jerry-weng/Lierda_tracker/ReadMe.txt

1.Telus  定位器 项目型号 LSD4BT0044-17D0 资料已归档-具体可问胡燕青查看
2.国内版 定位器 项目型号 LSD4BT0044-22D0 基于国内版，针对不同地区的情况，接入了不同的oc, 定制了不同功能

3.使用时请确认NB模组的固件版本是否为最新！
4.若程序无法打开 请复制到无中文路径文件夹中。
