jerry-weng/Lierda_tracker/产测源码与固件/ReadMe.txt

产测方案为杨彬与陈剑飞共同讨论设计
本源码为产测代码。
长按开机后由测试上位机自动完成测试流程
