jerry-weng/Lierda_tracker/服务器、oc与后台/ReadMe.txt

1.若要添加新设备，需首先在对应的服务器上导入相应设备
之后才能正常使用。
2.若要查询设备是否到达oc，可访问对应oc地址查看数据
（如果是国外oc可能需要翻墙）
