jerry-weng/Lierda_tracker/其他平台对应源码与固件/profile与编解码插件/ReadMe.txt

需在oc平台上上传的编解码插件与profile。 目前各个oc上面都已上传，由李磊磊负责
