jerry-weng/Lierda_tracker/其他平台对应源码与固件/台湾/ReadMe.txt

基于AIS_OC正式版 
分别寄送了
2个120的模组产品
2个150的模组产品
给台湾客户，源码
对应为TW_120和TW_150
