jerry-weng/Lierda_tracker/其他平台对应源码与固件/泰国/ReadMe.txt

1. AIS_OC正式版
最新功能软件，对应硬件为LSD4SA-NBTK000001_V01
若要使用新的硬件注意修改，参考文档 路径： 其他平台对应源码与固件/ReadMe.txt

2.AIS_OC定制版
基于1的软件，修改增加 上电自动开机、1分钟上报间隔等功能
若要使用新的硬件注意修改

3.True_OC
基于1的软件，修改南向IP地址
若要使用新的硬件注意修改

4.泰国_OC
实验室环境，产品测试认证用
