jerry-weng/Lierda_tracker/其他平台对应源码与固件/香港/ReadMe.txt

香港版为UDP版本，以一分钟的上报间隔，定时向测试的IP地址发送数据 --对应销售为 lierda赵夏
