jerry-weng/Lierda_tracker/固件下载工具/NB模组固件与下载软件/ReadMe.txt

1.若要更新NB模组程序 请使用UEUpdater 通过串口更新程序
2.不同的模块版本请对应，模组丝印上的型号即固件型号
比如 LSD4NBN-LB08000002_V02.03.fwpkg 即是Band8 的固件
