jerry-weng/Lierda_tracker/国内版本源码与固件/Doc/基站定位/ReadMe.txt

如果需要基站定位功能，需要联系中国电信开通对应SIM卡权限
MCU会通过NB模组读取SIM卡NCCID, 可通过NCCID（去掉最后一位校验位）对应的sim卡号调用电信所提供的接口获取基站信息（注：设备必须是在线或idle状态）

也可通过访问网站输入sim卡号信息来查看位置
https://www.ct10649.com:4821/ecportal/#
账号：fyb18067988525
密码：116040142Ckl

目前导入贤芯数据库的设备数量为400，若要增加请把新的对应excel发给贤芯对应人员 -- 路传军
