jerry-weng/Lierda_tracker/国内版本源码与固件/Doc/软件流程/协议/ReadMe.txt

由于当时打算做一个手环的项目，高坚和世东定义了一份coap协议
为了将目前的tracker兼容，CoAP协议——V01.02 文件中的数据信息填充字段，即为 NB-TRACKER-COAP国内版协议V1.6
