jerry-weng/Lierda_tracker/服务器、oc与后台/各OC地址.pdf

# 各OC地址

### 深圳OC

PS：开发测试⽤预留

开发者portal：https://120.234.26.167:8093 SP portal：https://120.234.26.167:8843账户/密码：lierda001/Lierda@001 南向设备对接地址：120.234.26.167
北向应⽤对接地址：120.234.26.167

### 泰国OC

PS：测试认证和泰国终端测试都⾛这个环境

开发者portal：https://203.172.115.67:8093
SP portal：https://203.172.115.67:8843账户/密码：Lierda001/Lierda.001 南向设备对接地址：10.10.45.196(内⽹) / 203.172.115.67(公⽹） 北向应⽤对接地址：10.10.46.196(私⽹) / 203.172.115.67(公⽹) 泰国应⽤服务器地址：10.10.36.88(私⽹，与oc对接使⽤) 泰国应⽤服务器域名：https://trackerars.lierda.com:50443

### AIS OC

SP portal：https://110.49.206.61:8843账户/密码：Lierda_APP/Lierda@2018 南向设备对接地址：10.143.132.1
北向应⽤对接地址：110.49.206.61

### 电信OC

PS：国内版使⽤

SP portal：https://180.101.146.80:8843账户/密码：lierdawulian/lierda_2017@NB 南向设备对接地址：117.60.157.137:5683 北向应⽤对接地址：https://device.api.ct10649.com:8743电信应⽤服务器域名：https://tracker.lierda-tracker.com

### 奥地利OC

SP portal：https://160.44.200.197/#/login账户/密码：HuaweiBonn_Lierda/Lierda_001 南向设备对接地址：160.44.206.237:5683 北向应⽤对接地址：160.44.201.125:8743

TRUE OC
ID：KCWZLMKtcDze6jlxV_280P7jfBoa 密码：ca7wzeK6TFTo1VroGet zoUwCnU0a 南向设备对接地址：180.214.223.116:5683 服务器平台订阅接⼝IP：180.214.223.118 8743/HTTPS https://180.214.223.118:8843/index.html ⽤户名Lierdaiot 密码Huawei@1234

1 https://10.10.46.196:8743 泰国OC 2 https://110.49.206.61:8743 AIS OC 3 https://120.234.26.167:8743 深圳OC 4.奥地利OC
5.trueOC
注：导⼊后台时注意OC 的序号
注2：在批量导⼊设备⾄泰国和AIS OC时，注意excel表格中，将设备名称这⼀栏填写为IMEI
