jerry-weng/Lierda_tracker/国内版本源码与固件/Doc/软件流程/数据上报与模式配置流程.pdf

硬件 | OC平台 （插件）

## 服务器

## 数据上报帧

上报

## 平台回复帧

(8字节，例：FAFA5B21C3DA0000
由插件决定)

## 服务器回复帧

## 休眠---等待 下个周期唤 醒上报

## 跳过前37字节 根据协议解析后续

数据

## 指令下发

## 有缓存指令

## 当前状态帧 更新当前状态

## 平台回复帧

(8字节，例：FAFA5B21C3DA0000
由插件决定)
