jerry-weng/Lierda_tracker/国内版本源码与固件/Doc/基站定位/NCCID.png

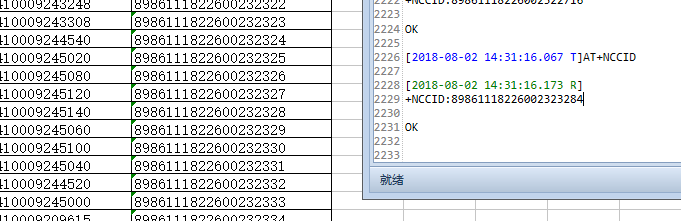
国内版本源码与固件/Doc/基站定位/NCCID.png
