jerry-weng/Lierda_tracker/服务器、oc与后台/app下载地址/coap版本.png

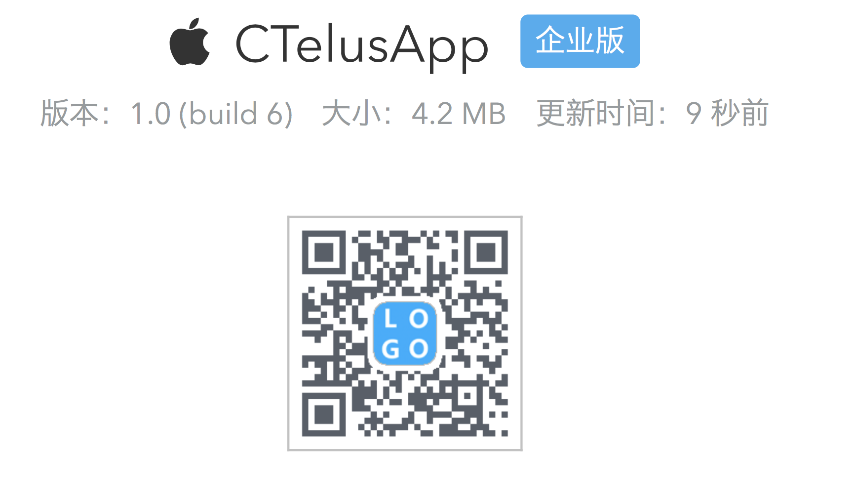
服务器、oc与后台/app下载地址/coap版本.png
