jerry-weng/Lierda_tracker/DeviceRegFileTemplate_2018-10-16 13_51_25.xls

Sheet: Sheet1
verifyCode | nodeId | psk | endUserId | timeout | name | mute | manufacturerId | manufacturerName | deviceType | model | region | location | protocolType | tags | timezone | latitude | longitude | address | groupId | customField | imsi | isSecure
865352030667058 | 865352030667058 | 12345678 |  | 0 |  | FALSE | LierdaWSN | LierdaWSN | NB05 | Band |  |  | Coap
865352030644444 | 865352030644444 | 12345678 |  | 0 |  | FALSE | LierdaWSN | LierdaWSN | NB05 | Band |  |  | Coap

Sheet: 参数说明
参数名称 | 字段说明
verifyCode | 验证码。用于设备注册和激活。 必选。 取值范围：长度不超过256的字符串。
nodeId | 设备唯一物理标识。需要和“verifyCode”值保持一致。 必选。 取值范围：长度不超过256的字符串。
psk | 随机psk参数。（psk：pre-shared key，预共享密钥。） 注册安全设备必选，非安全设备可选。 取值范围：长度为8～32的字符串,必须是16进制的字符。
endUserId | 终端用户ID。 可选。 取值范围：长度不超过256的字符串。
timeout | 超时时间。当调用北向接口对设备开户，在超时时间内可绑定设备，若超过timeout时间且未绑定设备，则会删除超时的开户信息。 可选。 取值范围：0～2147483647。若填写为“0”，则表示设备验证码不会失效（建议填写为“0”）。 默认值：180(默认值可配置，具体配置值请咨询物联网平台运维人员。) 单位：秒。
name | 设备名称。 可选。 取值范围：长度不超过256的字符串。 不能包含特殊符+/?%#|;&=
mute | 资产是否冻结。 可选。 取值范围： •“TRUE”：冻结资产，不可上报数据。 •“FALSE”：不冻结资产，可以上报数据。 • 建议填写为“FALSE“
manufacturerId | 厂商ID。 可选（建议填写）。 取值范围：长度不超过256的字符串。 | 为了避免接入的设备不可用。manufacturerId,manufacturerName,deviceType,model,protocolType字段需要与设备profile的字段值保持一致。
manufacturerName | 厂商名称。 可选（建议填写）。 取值范围：长度不超过256的字符串。
deviceType | 设备类型。 可选（建议填写）。 取值范围：长度不超过256的字符串。
model | 设备型号。 可选（建议填写）。 取值范围：长度不超过256的字符串。
region | 设备区域。 可选。 取值范围：长度不超过256的字符串。 不能包含特殊符+/?%#|;&=
location | 设备位置。 可选。 取值范围：长度不超过1024的字符串。 不能包含特殊符+/?%#|;&=
protocolType | 设备协议类型。 可选（建议填写）。 取值范围：长度不超过256的字符串。
tags | 标签。给设备打标签可以统一管理一类设备。 可选。 取值范围：长度不超过100个标签。
timeZone | 时区。设备所在区域的时区。 可选。 取值范围：长度不超过256的字符串。例如Asia/Shanghai、Asia/Tokyo、Europe/London
latitude | 纬度。设备所在的纬度。 可选。 取值范围：-90～90。
longitude | 纬度。设备所在的经度。 可选。 取值范围：-180～180。
address | 地址。设备地址。 可选。 取值范围：长度不超过256的字符串。
groupId | 组Id。设备所属群组的Id 可选。 取值范围：长度不超过256的字符串。
customField | 自定义字段。设备的自定义字段。 可选。 取值范围：长度不超过256个自定义字段。 示例：[{"fieldName":"owner","fieldValue":"SuperAdmin","fieldType":"String"}]
imsi | NB终端imsi，用于消息计费。 可选。 取值范围：长度不超过256的字符串。
isSecure | 设备安全模式。 可选。 取值范围：true 或者 false（当non-DTLS开关关闭时，默认true，设置无效。）

Sheet: Parameter Description
Parameter Name | Parameter Description
verifyCode | This parameter specifies a verification code, which is used to register and activate a device. This parameter is mandatory. Value: a string of a maximum of 256 characters
nodeId | This parameter uniquely identifies a device. This parameter is mandatory and must be consistent with verifyCode. Value: a string of a maximum of 256 characters
psk | This parameter specifies a pre-shared key. This parameter is mandatory for registered security devices and optional for registering non-secure devices. Value: a hexadecimal string of 8 to 32 characters
endUserId | This parameter identifies an end user. This parameter is optional. Value: a string of a maximum of 256 characters
timeout | This parameter specifies the timeout period for binding a device. When the northbound interface is called to register a device, the device can be bound within the timeout period. If the device is not bound within the timeout period, timeout registration information will be deleted.(recommended value: 0) This parameter is optional. Value range: 0-2147483647 (If this parameter is set to 0, the verification code will always be valid.) Default value: 180(The default value can be configured. For details on the specific value, contact IoT platform O&M personnel.) Unit: seconds
name | This parameter specifies the name of a device. This parameter is optional. Value: a string of a maximum of 256 characters, which cannot contain special characters +/?%#|;&=
mute | This parameter specifies whether an asset is frozen. This parameter is optional. Value: a string of a maximum of 256 characters Recommended value: FALSE
manufacturerId | This parameter specifies the ID of a manufacturer. This parameter is optional(You are advised to enter a value). Value: a string of a maximum of 256 characters | To ensure that the connected device can be used, set manufacturerId, manufacturerName, deviceType, model, and protocolType to the same as those in the device profile.
manufacturerName | This parameter specifies the name of a manufacturer. This parameter is optional(You are advised to enter a value). Value: a string of a maximum of 256 characters
deviceType | This parameter specifies the type of a device. This parameter is optional(You are advised to enter a value). Value: a string of a maximum of 256 characters
model | This parameter specifies the model of a device. This parameter is optional(You are advised to enter a value). Value: a string of a maximum of 256 characters
region | This parameter specifies the region of a device. This parameter is optional. Value: a string of a maximum of 256 characters, which cannot contain special characters +/?%#|;&=
location | This parameter specifies the location of a device. This parameter is optional. Value: a string of a maximum of 1024 characters, which cannot contain special characters +/?%#|;&=
protocolType | This parameter specifies the protocol used by a device. This parameter is optional(You are advised to enter a value). Value: a string of a maximum of 256 characters
tags | This parameter specifies device label can manage the type of device centrally. This parameter is optional. Value: length does not exceed 100 label
timeZone | This parameter specifies the time zone of the area where the device is located. This parameter is optional. Value: a string of a maximum of 256 characters", e.g.,Asia/Shanghai, Asia/Tokyo, Europe/London
latitude | This parameter specifies the latitude where the device is located. This parameter is optional. Value range: -90 to 90
longitude | This parameter specifies the longitude where the device is located. This parameter is optional. Value range: -180 to 180
address | This parameter specifies the device address. This parameter is optional. Value: a string of a maximum of 256 characters
groupId | This parameter identifies the group to which the device belongs. This parameter is optional. Value: a string of a maximum of 256 characters
customField | This parameter specifies the field customized for the device. It is available for the batch device registration function on the NAE portal, not the SP portal. This parameter is optional. Value: a string of a maximum of 256 characters Example: [{"fieldName":"owner","fieldValue":"SuperAdmin","fieldType":"String"}]
imsi | This parameter specifies the IMSI of an NB-IoT device. It is used for message charging. This parameter is optional. Value: a string of a maximum of 64 characters
isSecure | This parameter specifies the security mode of a device. This parameter is optional. Value: TRUE or FALSE (If the non-DTLS switch is disabled, this parameter is set to TRUE by default, indicating that the security mode setting is invalid.)
