jerry-weng/Lierda_tracker/硬件相关/位号图/LSD4BT0044-17D0_位号图(BOT)_Rev05.pdf

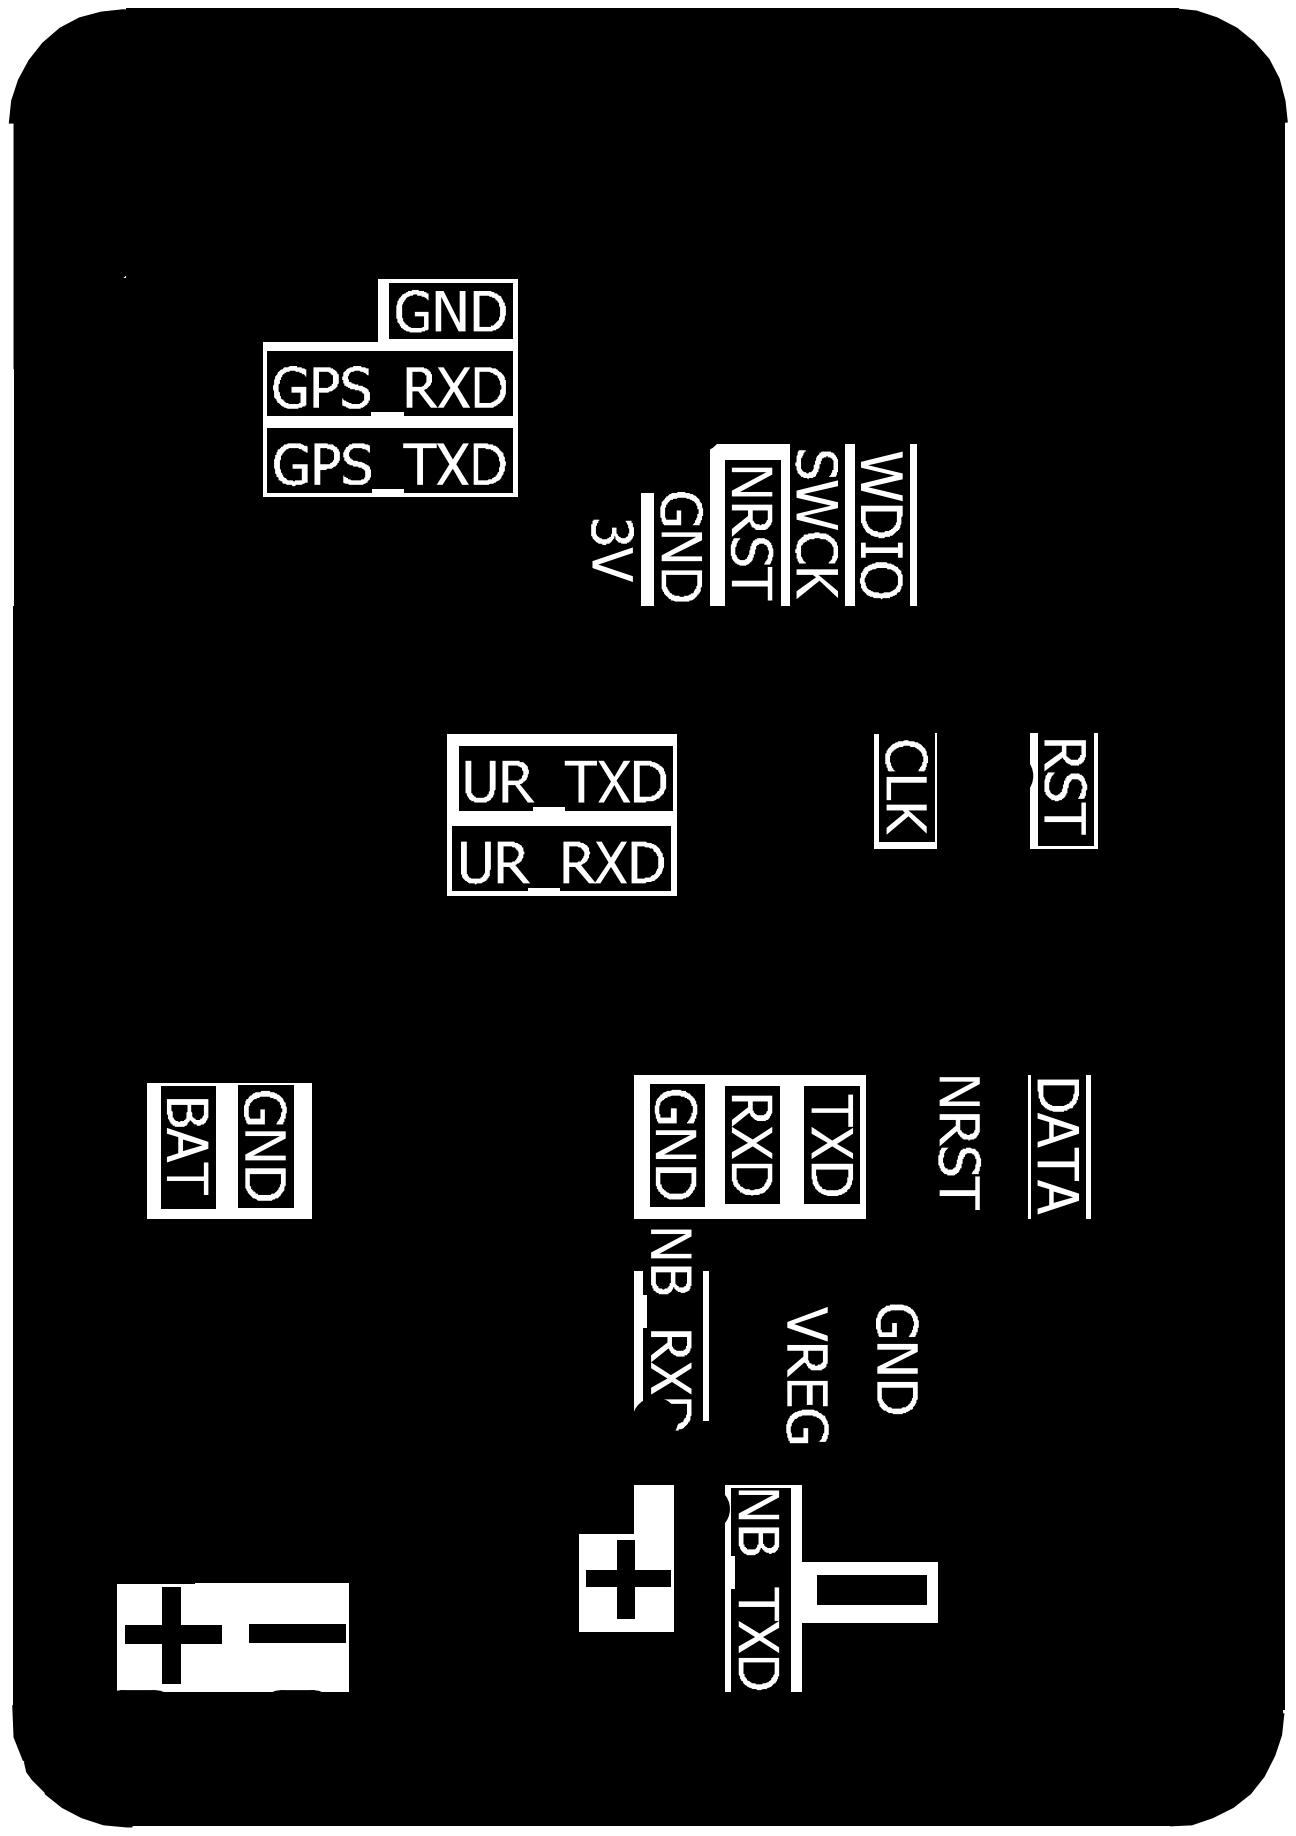
[picture p7: page 1]
