jerry-weng/Lierda_tracker/硬件相关/位号图/LSD4BT0044-17D0_位号图(TOP)_Rev05.pdf

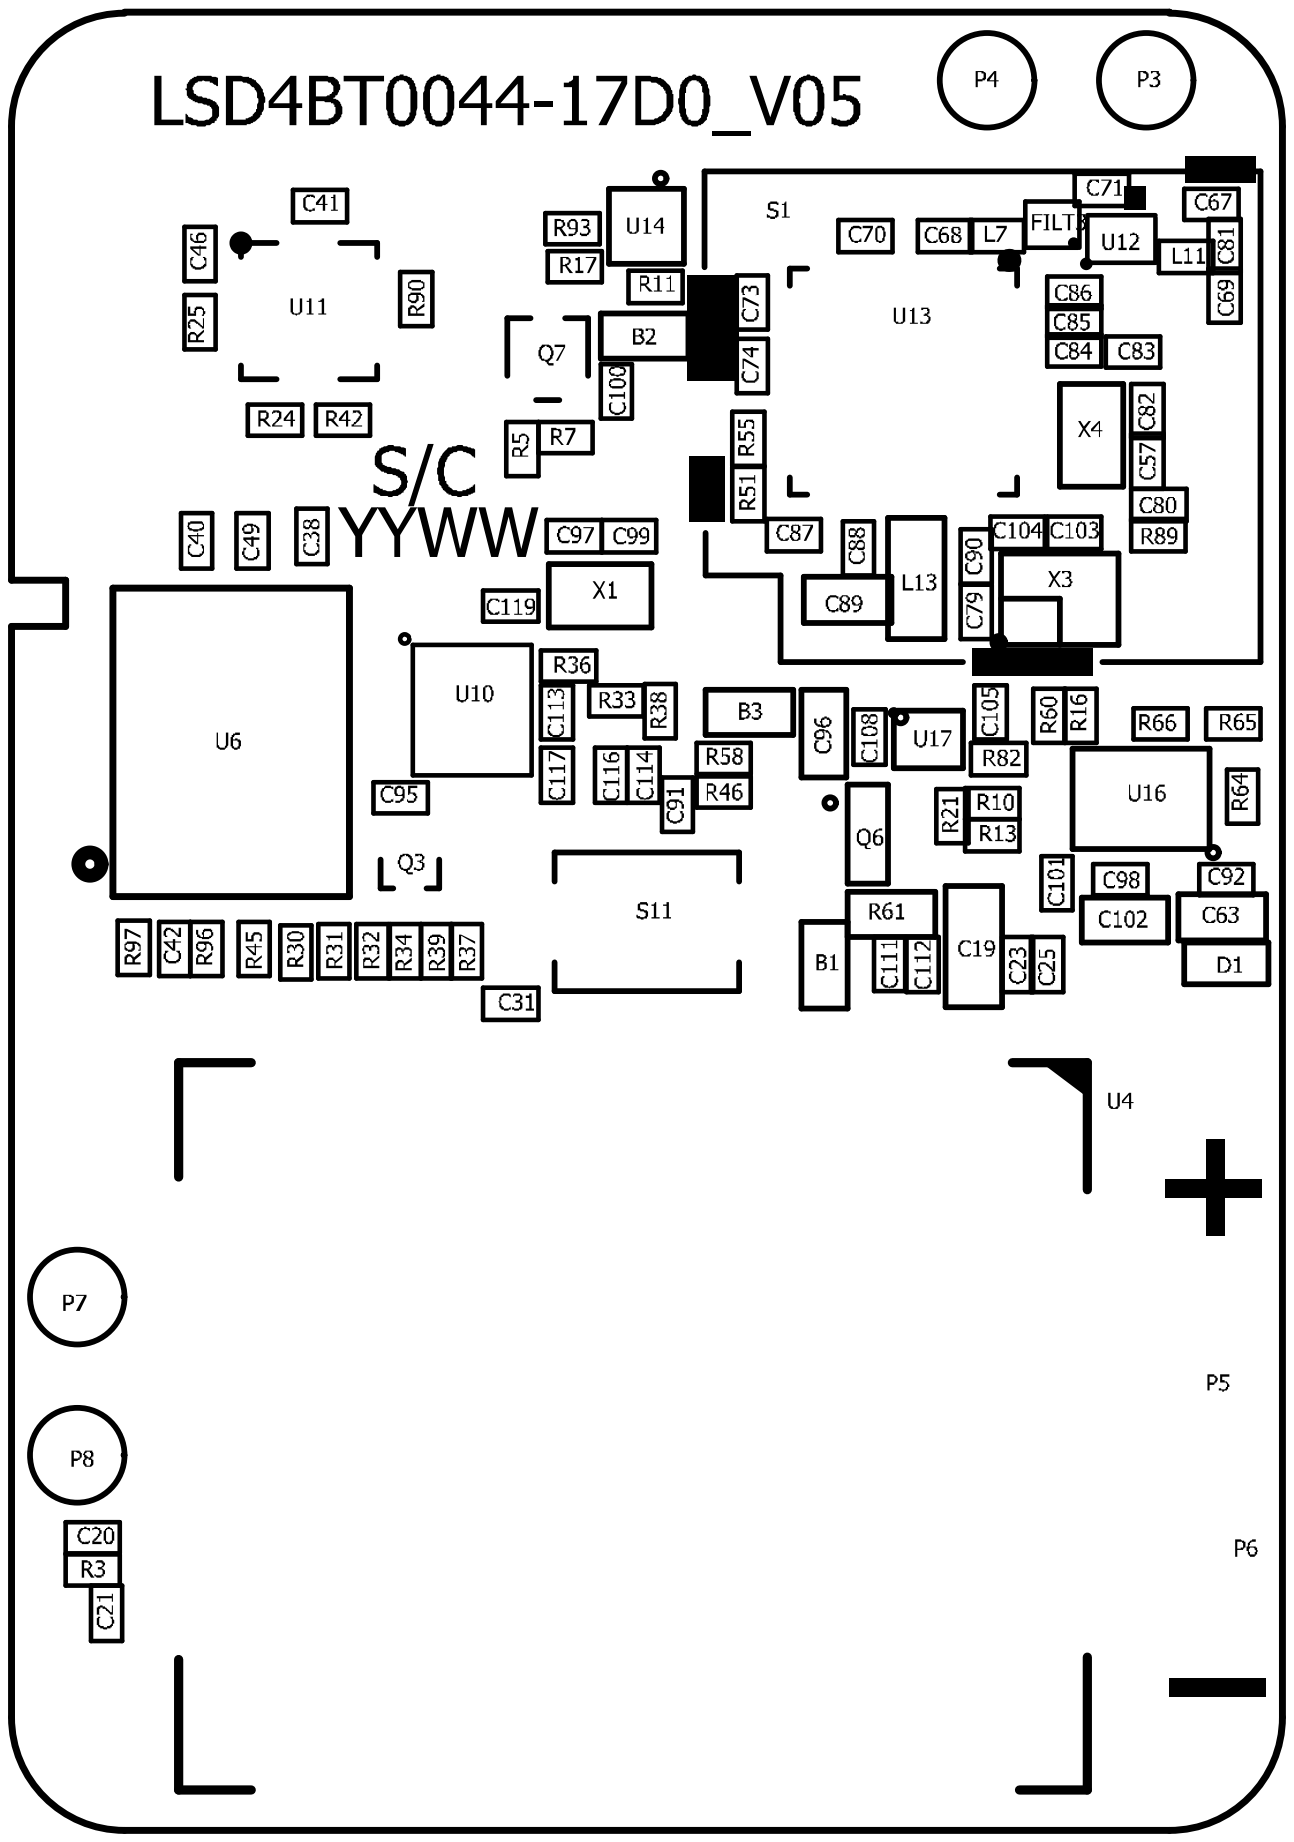
[picture p8: page 1]
