jerry-weng/Lierda_tracker/国内版本源码与固件/Doc/软件流程/硬件开机注册流程.pdf

硬件 | OC平台 （插件）

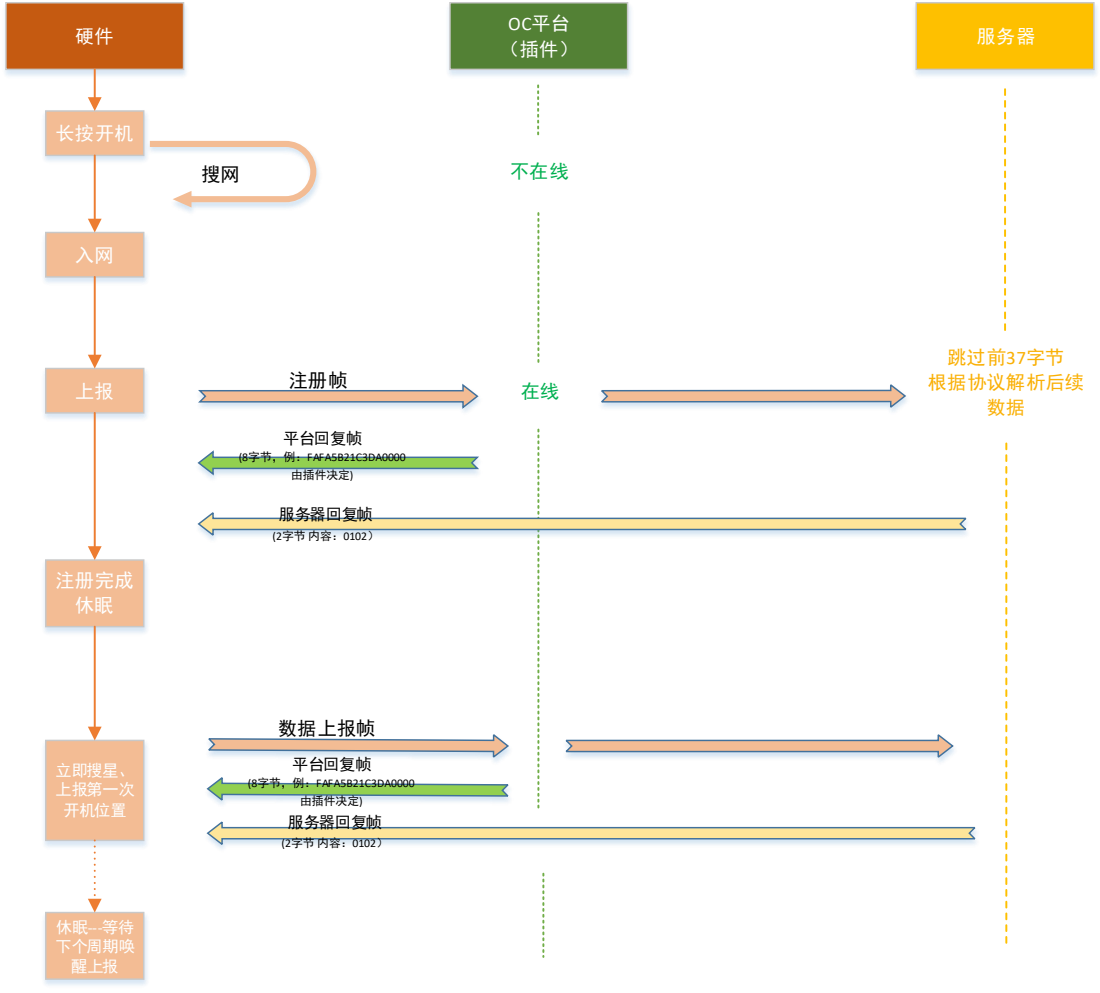
[picture p9: page 1]
服务器; 注册帧; 长按开机; 注册完成 休眠; 立即搜星、 上报第一次 开机位置; 不在线; 平台回复帧; (8字节，例：FAFA5B21C3DA0000; 由插件决定); 服务器回复帧; 数据上报帧; 由插件决定) 服务器回复帧; 休眠---等待 下个周期唤 醒上报; 跳过前37字节 根据协议解析后续 数据
