jerry-weng/Lierda_tracker/Telus版本源码与固件/Locator_L051T8_Schedule0719_150/Locator_L051T8.ioc

Mcu.UserName=STM32L051T8Yx
PA0.GPIO_Label=KEY
PA0.Signal=GPXTI0
PA10.Signal=USART1_RX
PA11.GPIO_Label=GPS_SW
PA11.Signal=GPIO_Output
PA12.GPIO_Label=GPS_INT
PA12.Signal=GPIO_Input
PA13.Signal=SYS_SWDIO
PA14.Signal=SYS_SWCLK
PA15.GPIO_Label=LED3_G
PA15.Signal=GPIO_Output
PA2.Signal=USART2_TX
PA3.Signal=USART2_RX
PA4.GPIO_Label=BAT_V_DET
PA4.Signal=ADC_IN4
PA5.GPIO_Label=NPPR
PA5.Signal=GPXTI5
PA6.GPIO_Label=NCHG
PA6.Signal=GPXTI6
PA8.GPIO_Label=GPS_RST
PA8.Signal=GPIO_Output
PA9.Signal=USART1_TX
PB0.GPIO_Label=NB_SW
PB0.Signal=GPIO_Output
PB1.GPIO_Label=NB_RI
PB1.Signal=GPIO_Input
PB10.Signal=LPUART1_TX
PB11.Signal=LPUART1_RX
PB2.GPIO_Label=NB_RESET
PB2.Signal=GPIO_Output
PB3.GPIO_Label=LED2_B
PB3.Signal=GPIO_Output
PB4.GPIO_Label=LED1_R
PB4.Signal=GPIO_Output
PB5.GPIO_Label=PS_INT
PB5.Signal=GPIO_Input
PC14-OSC32_IN.Signal=RCC_OSC32_IN
PC15-OSC32_OUT.Signal=RCC_OSC32_OUT
