jerry-weng/Lierda_tracker/其他平台对应源码与固件/台湾/Locator_L051T8_AIS_alarm_AIS_NW_OTA2_SENSOR_TW120/Src/usart.c

/**
  ******************************************************************************
  * File Name          : USART.c
  * Description        : This file provides code for the configuration
  *                      of the USART instances.
  ******************************************************************************
  ** This notice applies to any and all portions of this file
  * that are not between comment pairs USER CODE BEGIN and
  * USER CODE END. Other portions of this file, whether 
  * inserted by the user or by software development tools
  * are owned by their respective copyright owners.
  *
  * COPYRIGHT(c) 2017 STMicroelectronics
  *
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
  ******************************************************************************
  */

/* Includes ------------------------------------------------------------------*/
#include "usart.h"

#include "gpio.h"
#include "dma.h"

/* USER CODE BEGIN 0 */
USART_RECEIVETYPE UsartType;
USART_RECEIVETYPE2 UsartType2;
/* USER CODE END 0 */

UART_HandleTypeDef hlpuart1;
UART_HandleTypeDef huart1;
UART_HandleTypeDef huart2;
DMA_HandleTypeDef hdma_lpuart1_rx;
DMA_HandleTypeDef hdma_lpuart1_tx;
DMA_HandleTypeDef hdma_usart1_rx;
DMA_HandleTypeDef hdma_usart1_tx;
DMA_HandleTypeDef hdma_usart2_rx;
DMA_HandleTypeDef hdma_usart2_tx;

/* LPUART1 init function */

void MX_LPUART1_UART_Init(void)
{

  hlpuart1.Instance = LPUART1;
  hlpuart1.Init.BaudRate = 9600;
  hlpuart1.Init.WordLength = UART_WORDLENGTH_8B;
  hlpuart1.Init.StopBits = UART_STOPBITS_1;
  hlpuart1.Init.Parity = UART_PARITY_NONE;
  hlpuart1.Init.Mode = UART_MODE_TX_RX;
  hlpuart1.Init.HwFlowCtl = UART_HWCONTROL_NONE;
  hlpuart1.Init.OneBitSampling = UART_ONE_BIT_SAMPLE_DISABLE;
  hlpuart1.AdvancedInit.AdvFeatureInit = UART_ADVFEATURE_NO_INIT;
  if (HAL_UART_Init(&hlpuart1) != HAL_OK)
  {
    _Error_Handler(__FILE__, __LINE__);
  }

}
/* USART1 init function */

void MX_USART1_UART_Init(void)
{

  huart1.Instance = USART1;
  huart1.Init.BaudRate = 9600;
  huart1.Init.WordLength = UART_WORDLENGTH_8B;
  huart1.Init.StopBits = UART_STOPBITS_1;
  huart1.Init.Parity = UART_PARITY_NONE;
  huart1.Init.Mode = UART_MODE_TX_RX;
  huart1.Init.HwFlowCtl = UART_HWCONTROL_NONE;
  huart1.Init.OverSampling = UART_OVERSAMPLING_16;
  huart1.Init.OneBitSampling = UART_ONE_BIT_SAMPLE_DISABLE;
  huart1.AdvancedInit.AdvFeatureInit = UART_ADVFEATURE_NO_INIT;
  if (HAL_UART_Init(&huart1) != HAL_OK)
  {
    _Error_Handler(__FILE__, __LINE__);
  }

}
/* USART2 init function */

void MX_USART2_UART_Init(void)
{

  huart2.Instance = USART2;
  huart2.Init.BaudRate = 9600;
  huart2.Init.WordLength = UART_WORDLENGTH_8B;
  huart2.Init.StopBits = UART_STOPBITS_1;
  huart2.Init.Parity = UART_PARITY_NONE;
  huart2.Init.Mode = UART_MODE_TX_RX;
  huart2.Init.HwFlowCtl = UART_HWCONTROL_NONE;
  huart2.Init.OverSampling = UART_OVERSAMPLING_16;
  huart2.Init.OneBitSampling = UART_ONE_BIT_SAMPLE_DISABLE;
  huart2.AdvancedInit.AdvFeatureInit = UART_ADVFEATURE_NO_INIT;
  if (HAL_UART_Init(&huart2) != HAL_OK)
  {
    _Error_Handler(__FILE__, __LINE__);
  }

}

void HAL_UART_MspInit(UART_HandleTypeDef* uartHandle)
{

  GPIO_InitTypeDef GPIO_InitStruct;
  if(uartHandle->Instance==LPUART1)
  {
    /* LPUART1 clock enable */
    __HAL_RCC_LPUART1_CLK_ENABLE();
  
    /**LPUART1 GPIO Configuration    
    PB11     ------> LPUART1_RX
    PB10     ------> LPUART1_TX 
    */
    GPIO_InitStruct.Pin = GPIO_PIN_11|GPIO_PIN_10;
    GPIO_InitStruct.Mode = GPIO_MODE_AF_PP;
    GPIO_InitStruct.Pull = GPIO_PULLUP;
    GPIO_InitStruct.Speed = GPIO_SPEED_FREQ_VERY_HIGH;
    GPIO_InitStruct.Alternate = GPIO_AF4_LPUART1;
    HAL_GPIO_Init(GPIOB, &GPIO_InitStruct);

    /* LPUART1 DMA Init */
    /* LPUART1_RX Init */
    hdma_lpuart1_rx.Instance = DMA1_Channel3;
    hdma_lpuart1_rx.Init.Request = DMA_REQUEST_5;
    hdma_lpuart1_rx.Init.Direction = DMA_PERIPH_TO_MEMORY;
    hdma_lpuart1_rx.Init.PeriphInc = DMA_PINC_DISABLE;
    hdma_lpuart1_rx.Init.MemInc = DMA_MINC_ENABLE;
    hdma_lpuart1_rx.Init.PeriphDataAlignment = DMA_PDATAALIGN_BYTE;
    hdma_lpuart1_rx.Init.MemDataAlignment = DMA_MDATAALIGN_BYTE;
    hdma_lpuart1_rx.Init.Mode = DMA_NORMAL;
    hdma_lpuart1_rx.Init.Priority = DMA_PRIORITY_LOW;
    if (HAL_DMA_Init(&hdma_lpuart1_rx) != HAL_OK)
    {
      _Error_Handler(__FILE__, __LINE__);
    }

    __HAL_LINKDMA(uartHandle,hdmarx,hdma_lpuart1_rx);

    /* LPUART1_TX Init */
    hdma_lpuart1_tx.Instance = DMA1_Channel2;
    hdma_lpuart1_tx.Init.Request = DMA_REQUEST_5;
    hdma_lpuart1_tx.Init.Direction = DMA_MEMORY_TO_PERIPH;
    hdma_lpuart1_tx.Init.PeriphInc = DMA_PINC_DISABLE;
    hdma_lpuart1_tx.Init.MemInc = DMA_MINC_ENABLE;
    hdma_lpuart1_tx.Init.PeriphDataAlignment = DMA_PDATAALIGN_BYTE;
    hdma_lpuart1_tx.Init.MemDataAlignment = DMA_MDATAALIGN_BYTE;
    hdma_lpuart1_tx.Init.Mode = DMA_NORMAL;
    hdma_lpuart1_tx.Init.Priority = DMA_PRIORITY_LOW;
    if (HAL_DMA_Init(&hdma_lpuart1_tx) != HAL_OK)
    {
      _Error_Handler(__FILE__, __LINE__);
    }

    __HAL_LINKDMA(uartHandle,hdmatx,hdma_lpuart1_tx);

    /* LPUART1 interrupt Init */
    HAL_NVIC_SetPriority(AES_RNG_LPUART1_IRQn, 0, 0);
    HAL_NVIC_EnableIRQ(AES_RNG_LPUART1_IRQn);
  }
  else if(uartHandle->Instance==USART1)
  {
    /* USART1 clock enable */
    __HAL_RCC_USART1_CLK_ENABLE();
  
    /**USART1 GPIO Configuration    
    PA10     ------> USART1_RX
    PA9     ------> USART1_TX 
    */
    GPIO_InitStruct.Pin = GPIO_PIN_10|GPIO_PIN_9;
    GPIO_InitStruct.Mode = GPIO_MODE_AF_PP;
    GPIO_InitStruct.Pull = GPIO_PULLUP;
    GPIO_InitStruct.Speed = GPIO_SPEED_FREQ_VERY_HIGH;
    GPIO_InitStruct.Alternate = GPIO_AF4_USART1;
    HAL_GPIO_Init(GPIOA, &GPIO_InitStruct);

    /* USART1 DMA Init */
    /* USART1_RX Init */
    hdma_usart1_rx.Instance = DMA1_Channel5;
    hdma_usart1_rx.Init.Request = DMA_REQUEST_3;
    hdma_usart1_rx.Init.Direction = DMA_PERIPH_TO_MEMORY;
    hdma_usart1_rx.Init.PeriphInc = DMA_PINC_DISABLE;
    hdma_usart1_rx.Init.MemInc = DMA_MINC_ENABLE;
    hdma_usart1_rx.Init.PeriphDataAlignment = DMA_PDATAALIGN_BYTE;
    hdma_usart1_rx.Init.MemDataAlignment = DMA_MDATAALIGN_BYTE;
    hdma_usart1_rx.Init.Mode = DMA_NORMAL;
    hdma_usart1_rx.Init.Priority = DMA_PRIORITY_LOW;
    if (HAL_DMA_Init(&hdma_usart1_rx) != HAL_OK)
    {
      _Error_Handler(__FILE__, __LINE__);
    }

    __HAL_LINKDMA(uartHandle,hdmarx,hdma_usart1_rx);

    /* USART1_TX Init */
    hdma_usart1_tx.Instance = DMA1_Channel4;
    hdma_usart1_tx.Init.Request = DMA_REQUEST_3;
    hdma_usart1_tx.Init.Direction = DMA_MEMORY_TO_PERIPH;
    hdma_usart1_tx.Init.PeriphInc = DMA_PINC_DISABLE;
    hdma_usart1_tx.Init.MemInc = DMA_MINC_ENABLE;
    hdma_usart1_tx.Init.PeriphDataAlignment = DMA_PDATAALIGN_BYTE;
    hdma_usart1_tx.Init.MemDataAlignment = DMA_MDATAALIGN_BYTE;
    hdma_usart1_tx.Init.Mode = DMA_NORMAL;
    hdma_usart1_tx.Init.Priority = DMA_PRIORITY_LOW;
    if (HAL_DMA_Init(&hdma_usart1_tx) != HAL_OK)
    {
      _Error_Handler(__FILE__, __LINE__);
    }

    __HAL_LINKDMA(uartHandle,hdmatx,hdma_usart1_tx);

    /* USART1 interrupt Init */
    HAL_NVIC_SetPriority(USART1_IRQn, 0, 0);
    HAL_NVIC_EnableIRQ(USART1_IRQn);
  }
  else if(uartHandle->Instance==USART2)
  {
    /* USART2 clock enable */
    __HAL_RCC_USART2_CLK_ENABLE();
  
    /**USART2 GPIO Configuration    
    PA2     ------> USART2_TX
    PA3     ------> USART2_RX 
    */
    GPIO_InitStruct.Pin = GPIO_PIN_2|GPIO_PIN_3;
    GPIO_InitStruct.Mode = GPIO_MODE_AF_PP;
    GPIO_InitStruct.Pull = GPIO_PULLUP;
    GPIO_InitStruct.Speed = GPIO_SPEED_FREQ_VERY_HIGH;
    GPIO_InitStruct.Alternate = GPIO_AF4_USART2;
    HAL_GPIO_Init(GPIOA, &GPIO_InitStruct);

    /* USART2 DMA Init */
    /* USART2_RX Init */
    hdma_usart2_rx.Instance = DMA1_Channel6;
    hdma_usart2_rx.Init.Request = DMA_REQUEST_4;
    hdma_usart2_rx.Init.Direction = DMA_PERIPH_TO_MEMORY;
    hdma_usart2_rx.Init.PeriphInc = DMA_PINC_DISABLE;
    hdma_usart2_rx.Init.MemInc = DMA_MINC_ENABLE;
    hdma_usart2_rx.Init.PeriphDataAlignment = DMA_PDATAALIGN_BYTE;
    hdma_usart2_rx.Init.MemDataAlignment = DMA_MDATAALIGN_BYTE;
    hdma_usart2_rx.Init.Mode = DMA_NORMAL;
    hdma_usart2_rx.Init.Priority = DMA_PRIORITY_LOW;
    if (HAL_DMA_Init(&hdma_usart2_rx) != HAL_OK)
    {
      _Error_Handler(__FILE__, __LINE__);
    }

    __HAL_LINKDMA(uartHandle,hdmarx,hdma_usart2_rx);

    /* USART2_TX Init */
    hdma_usart2_tx.Instance = DMA1_Channel7;
    hdma_usart2_tx.Init.Request = DMA_REQUEST_4;
    hdma_usart2_tx.Init.Direction = DMA_MEMORY_TO_PERIPH;
    hdma_usart2_tx.Init.PeriphInc = DMA_PINC_DISABLE;
    hdma_usart2_tx.Init.MemInc = DMA_MINC_ENABLE;
    hdma_usart2_tx.Init.PeriphDataAlignment = DMA_PDATAALIGN_BYTE;
    hdma_usart2_tx.Init.MemDataAlignment = DMA_MDATAALIGN_BYTE;
    hdma_usart2_tx.Init.Mode = DMA_NORMAL;
    hdma_usart2_tx.Init.Priority = DMA_PRIORITY_LOW;
    if (HAL_DMA_Init(&hdma_usart2_tx) != HAL_OK)
    {
      _Error_Handler(__FILE__, __LINE__);
    }

    __HAL_LINKDMA(uartHandle,hdmatx,hdma_usart2_tx);

    /* USART2 interrupt Init */
    HAL_NVIC_SetPriority(USART2_IRQn, 0, 0);
    HAL_NVIC_EnableIRQ(USART2_IRQn);
  }
}

void HAL_UART_MspDeInit(UART_HandleTypeDef* uartHandle)
{

  if(uartHandle->Instance==LPUART1)
  {
    /* Peripheral clock disable */
    __HAL_RCC_LPUART1_CLK_DISABLE();
  
    /**LPUART1 GPIO Configuration    
    PB11     ------> LPUART1_RX
    PB10     ------> LPUART1_TX 
    */
    HAL_GPIO_DeInit(GPIOB, GPIO_PIN_11|GPIO_PIN_10);

    /* LPUART1 DMA DeInit */
    HAL_DMA_DeInit(uartHandle->hdmarx);
    HAL_DMA_DeInit(uartHandle->hdmatx);

    /* LPUART1 interrupt Deinit */
    HAL_NVIC_DisableIRQ(AES_RNG_LPUART1_IRQn);
  }
  else if(uartHandle->Instance==USART1)
  {
    /* Peripheral clock disable */
    __HAL_RCC_USART1_CLK_DISABLE();
  
    /**USART1 GPIO Configuration    
    PA10     ------> USART1_RX
    PA9     ------> USART1_TX 
    */
    HAL_GPIO_DeInit(GPIOA, GPIO_PIN_10|GPIO_PIN_9);

    /* USART1 DMA DeInit */
    HAL_DMA_DeInit(uartHandle->hdmarx);
    HAL_DMA_DeInit(uartHandle->hdmatx);

    /* USART1 interrupt Deinit */
    HAL_NVIC_DisableIRQ(USART1_IRQn);
  }
  else if(uartHandle->Instance==USART2)
  {
    /* Peripheral clock disable */
    __HAL_RCC_USART2_CLK_DISABLE();
  
    /**USART2 GPIO Configuration    
    PA2     ------> USART2_TX
    PA3     ------> USART2_RX 
    */
    HAL_GPIO_DeInit(GPIOA, GPIO_PIN_2|GPIO_PIN_3);

    /* USART2 DMA DeInit */
    HAL_DMA_DeInit(uartHandle->hdmarx);
    HAL_DMA_DeInit(uartHandle->hdmatx);

    /* USART2 interrupt Deinit */
    HAL_NVIC_DisableIRQ(USART2_IRQn);
  }
} 

/* USER CODE BEGIN 1 */
//#ifdef __GNUC__
///* With GCC, small printf (option LD Linker->Libraries->Small printf
//   set to 'Yes') calls __io_putchar() */
//#define PUTCHAR_PROTOTYPE int __io_putchar(int ch)
//#else
//#define PUTCHAR_PROTOTYPE int fputc(int ch, FILE *f)
//#endif /* __GNUC__ */
//
///**
//  * @brief  Retargets the C library printf function to the USART.
//  * @param  None
//  * @retval None
//  */
//PUTCHAR_PROTOTYPE
//{
//  /* Place your implementation of fputc here */
//  /* e.g. write a character to the USART2 and Loop until the end of transmission */
//  HAL_UART_Transmit(&huart2, (uint8_t *)&ch, 1, 0xFFFF);
//
//  return ch;
//}

void UsartReceive_IDLE(UART_HandleTypeDef *huart)  
{  
    uint32_t temp;  
  
    if(huart->Instance == hlpuart1.Instance)
    {
        if((__HAL_UART_GET_FLAG(huart,UART_FLAG_IDLE) != RESET))  
        {   
            __HAL_UART_CLEAR_IDLEFLAG(&hlpuart1);  
            HAL_UART_DMAStop(&hlpuart1);  
            temp = hlpuart1.hdmarx->Instance->CNDTR;  
            UsartType.RX_Size =  RX_LEN - temp;   
            UsartType.RX_flag=1;  
            HAL_UART_Receive_DMA(&hlpuart1,UsartType.RX_pData,RX_LEN);  
        }
    }
    if(huart->Instance == huart1.Instance)
    {
        if((__HAL_UART_GET_FLAG(huart,UART_FLAG_IDLE) != RESET))  
        {   
            __HAL_UART_CLEAR_IDLEFLAG(&huart1);  
            HAL_UART_DMAStop(&huart1);  
            temp = huart1.hdmarx->Instance->CNDTR;  
            UsartType.RX_Size =  RX_LEN - temp;   
            UsartType.RX_flag=1;
            HAL_UART_Receive_DMA(&huart1,UsartType.RX_pData,RX_LEN);  
        }
    }
    if(huart->Instance == huart2.Instance)
    {
        if((__HAL_UART_GET_FLAG(huart,UART_FLAG_IDLE) != RESET))  
        {   
            __HAL_UART_CLEAR_IDLEFLAG(&huart2);  
            HAL_UART_DMAStop(&huart2);  
            temp = huart2.hdmarx->Instance->CNDTR;
            UsartType2.RX_Size =  RX_LEN - temp;   
            UsartType2.RX_flag=1;  
            HAL_UART_Receive_DMA(&huart2,UsartType2.RX_pData,RX_LEN);
        }
    }
} 

/* USER CODE END 1 */

/**
  * @}
  */

/**
  * @}
  */

/************************ (C) COPYRIGHT STMicroelectronics *****END OF FILE****/
