jerry-weng/Lierda_tracker/其他平台对应源码与固件/台湾/Locator_L051T8_AIS_alarm_AIS_NW_OTA2_SENSOR_TW120/Inc/crc16.h

/*******************************************************************************
    Copyright:          Lierda WSN BT team
    Filename:           crc16.h
    Description:        CRC16_H
    FileVersion:        

    ChangeLog: 

    =========================================
    date:2018/7/19
    author:Chenkl
    log: Create File


*******************************************************************************/

#ifndef CRC16_H
#define CRC16_H

#ifdef __cplusplus
extern "C" {
#endif

/*********************************************************************
 * INCLUDES
 */
 
 
 
/*********************************************************************
 * MACROS
 */
 
 
 
/*********************************************************************
 * CONSTANTS
 */

    
    
    
/*********************************************************************
 * TYPEDEFS
 */


/*********************************************************************
*  EXTERNAL VARIABLES
*/



/*********************************************************************
 * API FUNCTIONS
 */
int crc_check(unsigned char *message,int len);



/*********************************************************************
*********************************************************************/  

#ifdef __cplusplus
}
#endif

#endif /* CRC16_H */
