jerry-weng/Lierda_tracker/(notices)

Notices in the files:
其他平台对应源码与固件/泰国/AIS_OC正式版/Locator_L051T8_AIS_alarm_AIS_NW_OTA2_SENSOR_T_YEBO/Src/flash.c:
°æÈ¨ËùÓÐ (C)2014-2015 Àû¶û´ï¿Æ¼¼ÓÐÏÞ¹«Ë¾
其他平台对应源码与固件/泰国/AIS_OC正式版/Locator_L051T8_AIS_alarm_AIS_NW_OTA2_SENSOR_T_YEBO/Src/printf-stdarg.c:
This program is free software; you can redistribute it and/or modify
it under the terms of the GNU Lesser General Public License as published by
the Free Software Foundation; either version 2 of the License, or
(at your option) any later version.
